FraMac59/ELS-Reborn/README.md

the program is born in Italian language and is based on the arduino UNO R4 Minima
the program is for the arduino IDE 1.8.19 or later
the gerber files are developped with kicad
the features of the ELS-Reborn are:
- Velocita’ Mandrino
- Movimento Veloce
- Movimento Lento
- Avanzamento Libero
- Avanzamento Vincolato
- Filettatura
- Posizione Angolare
- Impostazioni
- Salva Setup
- Ripristina Default
- Test EMI
- The presence of an encoder with 3 channels is recomended ( Z, A, B ) for thread operations
- is possible to install two safety end-stroke managed by interrupt to avoiding collisions
